tomwolfe/heat-pump-defrost/(list of files, drawings)

Other design files:
v2.fzz
