tomwolfe/heat-pump-defrost/(commit log)

2021-08-18 logic fixes. Use heat index. more logical variable names.
    [sketch.ino]
2021-08-18 limit lcd display/heat_index to 2 decimals
2021-08-21 fix button. Tested working.
    millis() can't be used in hardware interrupts. replacing with button library. Finally tested and it seems to be working.
    [sketch.ino]
2021-08-24 track+display current/total defrost/run times. Better predictions
    track+display current/total defrost/run times. More accurate defrost predictions.
2021-08-26 display predicted Defrost time and samples
2021-08-27 max_diff for current cycle and resetDisplay to deal with EMF
    [sketch.ino]
2021-08-27 use millis instead of delay
2021-09-01 smaller steps for learning correct defrost time
    scalar. not ideal, but should avoid 2x'ing defrost time for each time it turns on from failure/more granular/smaller steps.
    [sketch.ino]
2022-04-03 lockout timer for undertemp. fix max_diff_cycle.
    [sketch.ino]
2022-04-25 implement setback for undertemp. fix playTone calls
    [sketch.ino]
2022-04-25 bugfix: int can't be negative. neverending
    [sketch.ino]
2022-04-25 bugfix, off by 1 again.
    [sketch.ino]
2022-04-26 fix Undertemp/target being hit locking display?
    still need to test, but compiles and should not block lcdLogic() call now.
    [sketch.ino]
2022-09-27 spin off into arduino branch
2022-10-04 initial esp32/iot cloud
2022-10-08 tested working on esp32
2022-10-14 hopefully fix some bugs with target/undertemp
    [sketch.ino]
2022-10-16 read out temperatures on google home
